frank26080115/SoccerRobot2019/circuit/pcbway_config.PNG

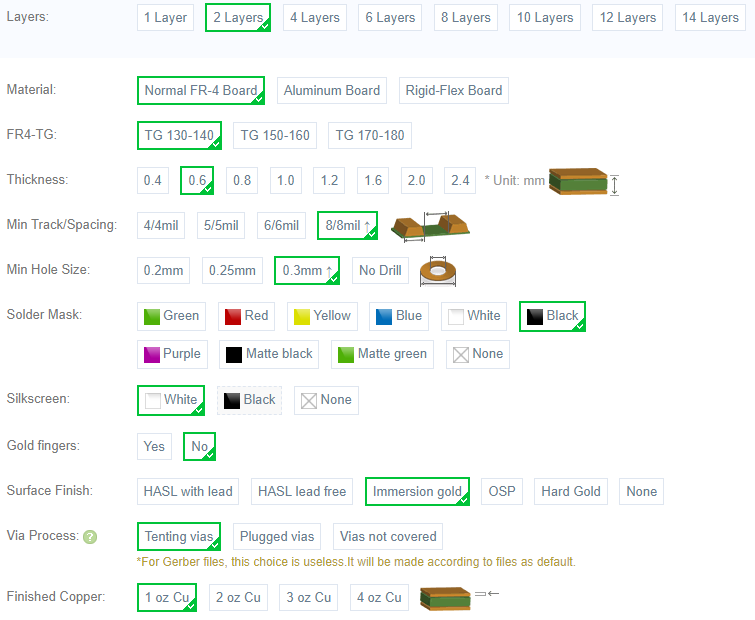
circuit/pcbway_config.PNG
