frank26080115/SoccerRobot2019/circuit/dirtcheaprxnano_billofmaterials.xlsx

Sheet: Bill of Materials
 |  |  | BOM: dirtcheaprx_nano
Item # | *Ref Des | *Qty | Mfg | *Mfg Part # | Description / Value | *Package | Type | Your Instructions / Notes
1 | U1 | 1 | Espressif | ESP-12E | ESP8266 Module | Module | SMD | ESP-12F and ESP-12S are acceptable
2 | IC1 | 1 | Microchip | MCP1703T-3302E/CB | Voltage Regulator +3.3V Output, 250mA | SOT-23-3 | SMD | No substitute
3 | C1 | 1 | *any* | *any* | CAP CER, 22 uF, 16V rated | 0805 | SMD | any temperature coeff, any tolerance
3 | C2 | 1 | *any* | *any* | CAP CER, 4.7 uF, 16V rated | 0805 | SMD | any temperature coeff, any tolerance
4 | C3 | 1 | *any* | *any* | CAP CER, 100 nF, 6V rated | 0603 | SMD | any temperature coeff, any tolerance, 100 nF to 1 uF acceptable
5 | R1, R4, R5 | 3 | *any* | *any* | RES 5.6 kohm, 10%, 1/10W | 0603 | SMD
6 | R2, R3 | 2 | *any* | *any* | RES 470 ohm, 10%, 1/10W | 0603 | SMD
Click for Instructions on How to Create a BOM (https://www.pcbway.com/blog/PCB_Assembly/How_to_Build_a_BOM__Bill_Of_Materials_.html)
PLEASE NOTE: COMPONENT COORDINATES ARE PROVIDED IN THIS FILE, IN ANOTHER SHEET

Sheet: Component Coordinates
Ref Des | X (mm) | Y (mm) | Rotation | Side | Footprint | Note
C1 | 11.50 | 9.90 | 90 | Top | 0805
C2 | 10.50 | 13.50 | 90 | Top | 0805
C3 | 16.90 | 12.55 | 0 | Top | 0603
IC1 | 8.00 | 11.95 | 0 | Top | SOT-23-3
R1 | 12.50 | 13.40 | 90 | Top | 0603
R2 | 14.50 | 13.40 | 90 | Top | 0603
R3 | 4.00 | 13.80 | 90 | Top | 0603
R4 | 17.30 | 9.80 | 90 | Top | 0603
R5 | 2.00 | 11.30 | 90 | Top | 0603
U1 | 9.8? | 10.6? | ??? | Bottom | Module | Unusual Part Package
