frank26080115/SoccerRobot2019/(threads)

Thread 2 (2018-10-09):

Robots can't move forward and turn at the same time

MiloMindbender, 2018-10-09:
The current implementation doesn't seem to be able to send rotate and forward/back commands at the same time.  This makes the robots harder to control.
