frank26080115/SoccerRobot2019/circuit/robot.brd

## EAGLE design circuit/robot.brd (2018-08-24)

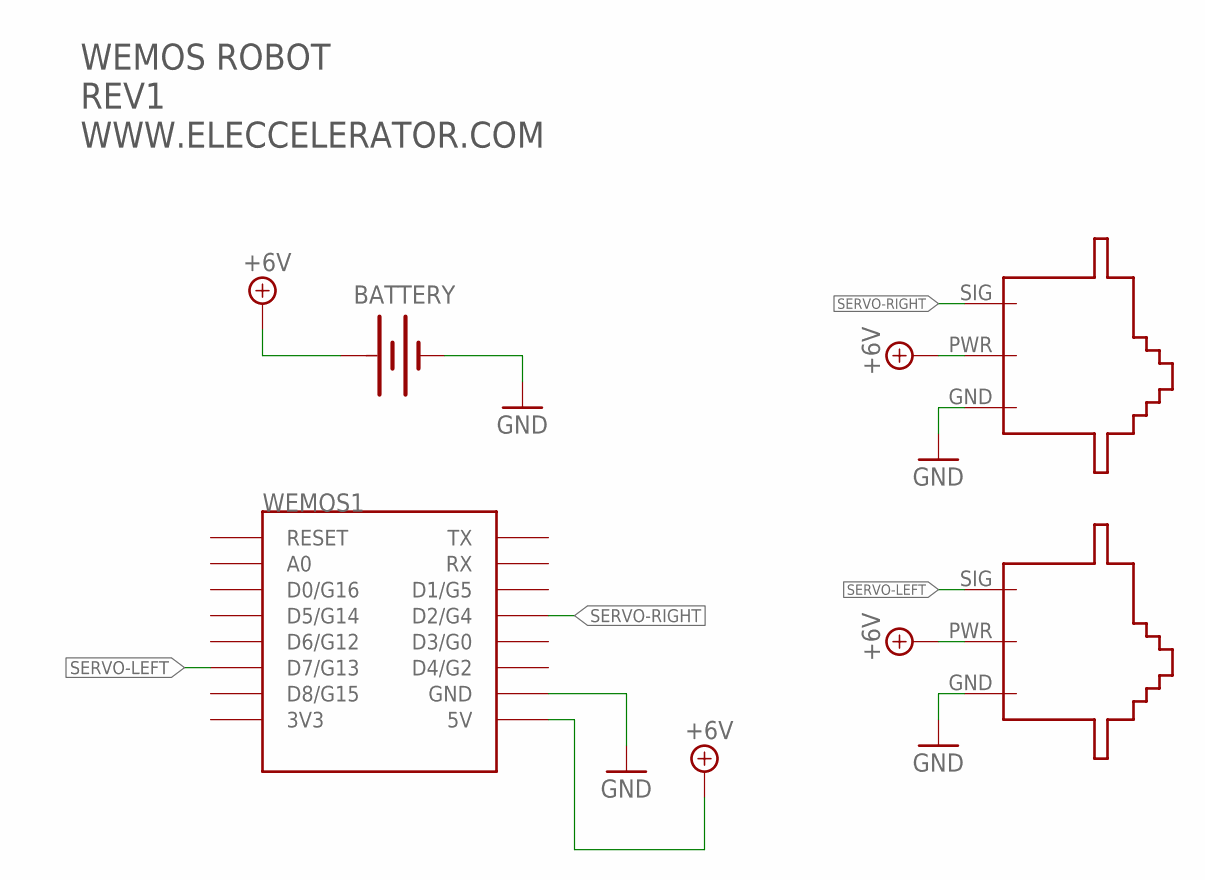
[picture p2: schematic robot.sch]

Parts:
BATTERY: BATTERY-WIRE-CONN; BATT-WIRE-CONN
M1: SERVO-FLIPPED
M2: SERVO-1; SERVO
U$1: HACKADAY-14MM; HACKADAY-1
U$9: TEXT-INFO-MINI
WEMOS1: WEMOS-D1-MINI

Connections:
+6V: BATTERY.POS (+), M1.PWR, M2.PWR, WEMOS1.5V
GND: BATTERY.NEG (-), M1.GND, M2.GND, WEMOS1.GND
SERVO-LEFT: M1.SIG, WEMOS1.D7 (D7/G13)
SERVO-RIGHT: M2.SIG, WEMOS1.D2 (D2/G4)

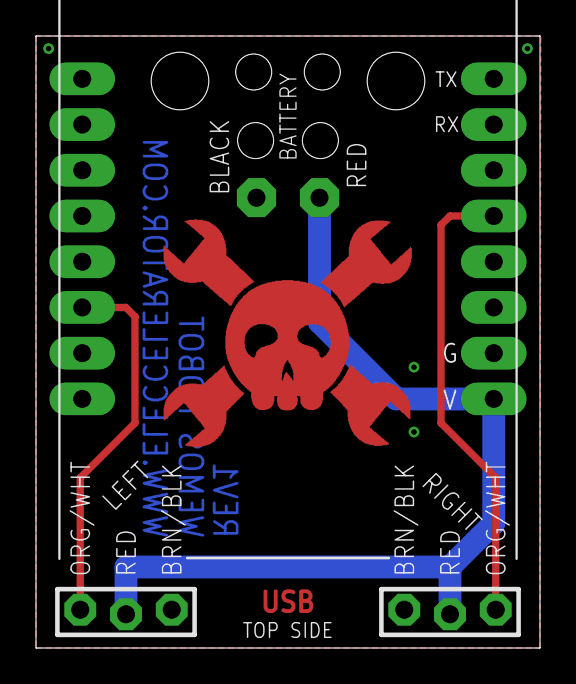
[picture p3: board robot.brd from above]

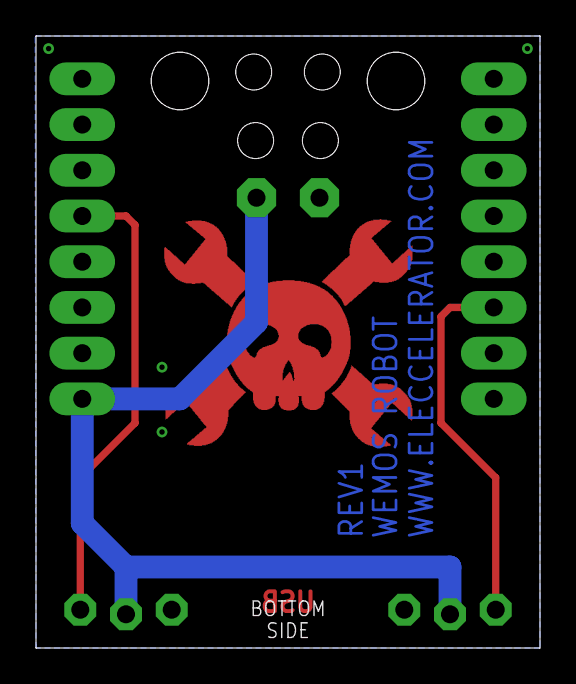
[picture p4: board robot.brd from below]

Board: 2 copper layers, 28.0 x 34.0 mm, 6 parts (2 on the bottom side), 4 nets.
