frank26080115/SoccerRobot2019/circuit/programmer.brd

## EAGLE design circuit/programmer.brd (2018-08-20)

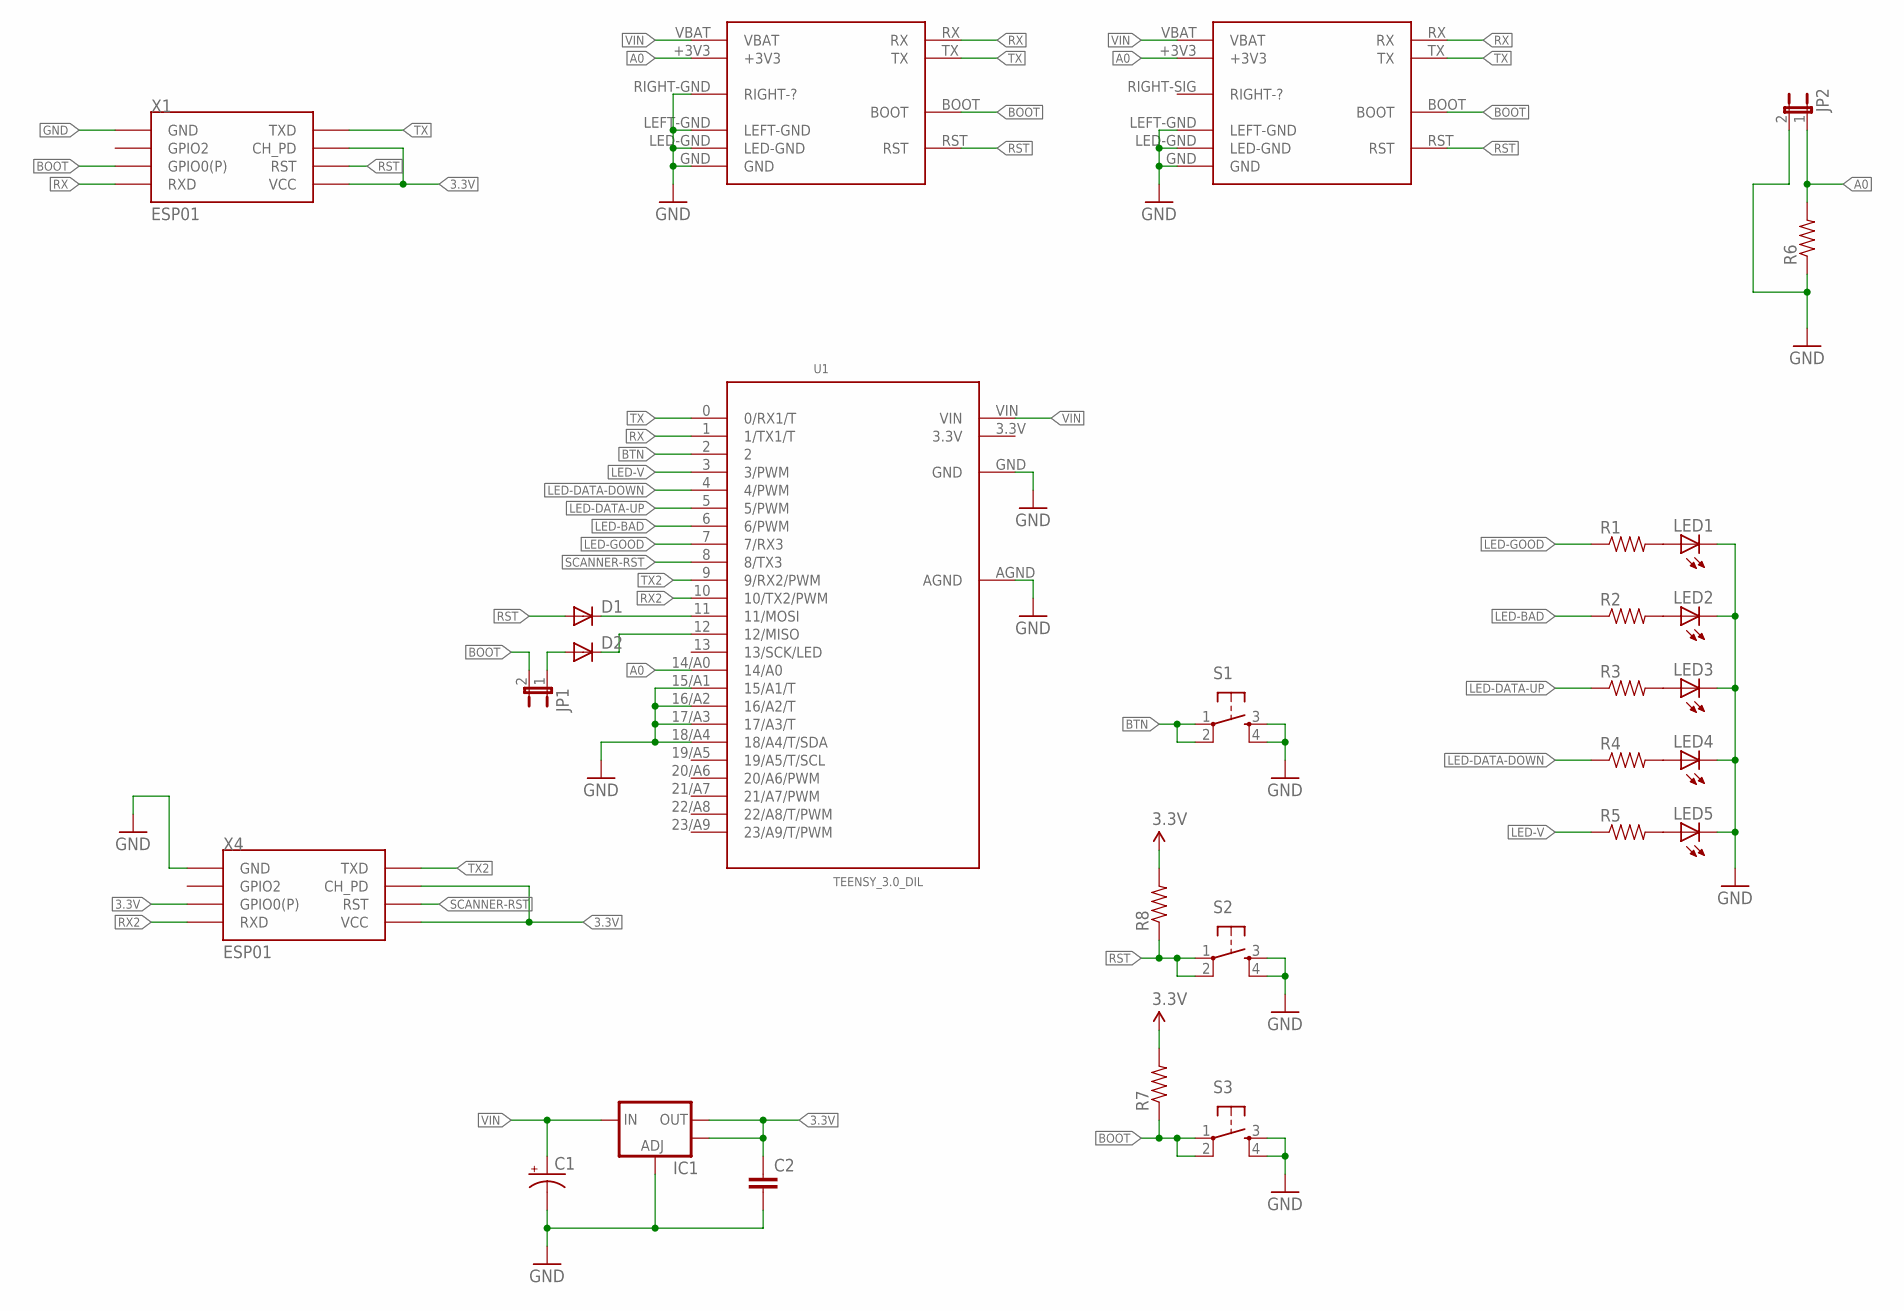
[picture p5: schematic programmer.sch]

Parts:
C1: CAP_POLPTH1; CPOL-RADIAL-100UF-25V
C2: CAPPTH2; CAP-PTH-SMALL2
D1, D2: DIODESOD; SOD-323
IC1: V_REG_LM1117SOT223; SOT223
JP1, JP2: JUMPER-2PTH_LOCK; 1X02_LOCK
LED1, LED2, LED3, LED4, LED5: LED5MM
R1, R2, R3, R4, R5, R6, R7, R8: RESISTOR0603-RES; 0603-RES
S1, S2, S3: TAC_SWITCHPTH; TACTILE-PTH
U1: TEENSY_3.0_DIL; TEENSY_3.0-3.2&LC_DIL
X1, X4: ESP01
X2: DIRTCHEAPRX-PROG-MINI; DIRTCHEAPRX_MINI_PROGPINS
X3: DIRTCHEAPRX-PROG-NANO; DIRTCHEAPRX_NANO_PROGPINS

Connections:
3.3V: C2.1, IC1.2 (OUT), IC1.4 (OUT), R7.2, R8.2, U1.3.3V, X1.CH_PD, X1.VCC, X4.CH_PD, X4.GPIO0 (GPIO0(P)), X4.VCC
A0: JP2.1, R6.2, U1.14/A0, X2.+3V3, X3.+3V3
BOOT: JP1.2, R7.1, S3.1, S3.2, X1.GPIO0 (GPIO0(P)), X2.BOOT, X3.BOOT
BTN: S1.1, S1.2, U1.2
GND: C1.2 (-), C2.2, IC1.1 (ADJ), JP2.2, LED1.K (C), LED2.K (C), LED3.K (C), LED4.K (C), LED5.K (C), R6.1, S1.3, S1.4, S2.3, S2.4, S3.3, S3.4, U1.15/A1 (15/A1/T), U1.16/A2 (16/A2/T), U1.17/A3 (17/A3/T), U1.18/A4 (18/A4/T/SDA), U1.AGND, U1.GND, X1.GND, X2.GND, X2.LED-GND, X2.LEFT-GND, X2.RIGHT-GND (RIGHT-?), X3.GND, X3.LED-GND, X3.LEFT-GND, X4.GND
LED-BAD: R2.1, U1.6 (6/PWM)
LED-DATA-DOWN: R4.1, U1.4 (4/PWM)
LED-DATA-UP: R3.1, U1.5 (5/PWM)
LED-GOOD: R1.1, U1.7 (7/RX3)
LED-V: R5.1, U1.3 (3/PWM)
unnamed: D1.1 (C), U1.11 (11/MOSI)
unnamed: LED1.A, R1.2
unnamed: LED2.A, R2.2
unnamed: LED3.A, R3.2
unnamed: LED4.A, R4.2
unnamed: LED5.A, R5.2
unnamed: D2.1 (C), U1.12 (12/MISO)
unnamed: D2.2 (A), JP1.1
RST: D1.2 (A), R8.1, S2.1, S2.2, X1.RST, X2.RST, X3.RST
RX: U1.1 (1/TX1/T), X1.RX (RXD), X2.RX, X3.RX
RX2: U1.10 (10/TX2/PWM), X4.RX (RXD)
SCANNER-RST: U1.8 (8/TX3), X4.RST
TX: U1.0 (0/RX1/T), X1.TX (TXD), X2.TX, X3.TX
TX2: U1.9 (9/RX2/PWM), X4.TX (TXD)
VIN: C1.1 (+), IC1.3 (IN), U1.VIN, X2.VBAT, X3.VBAT

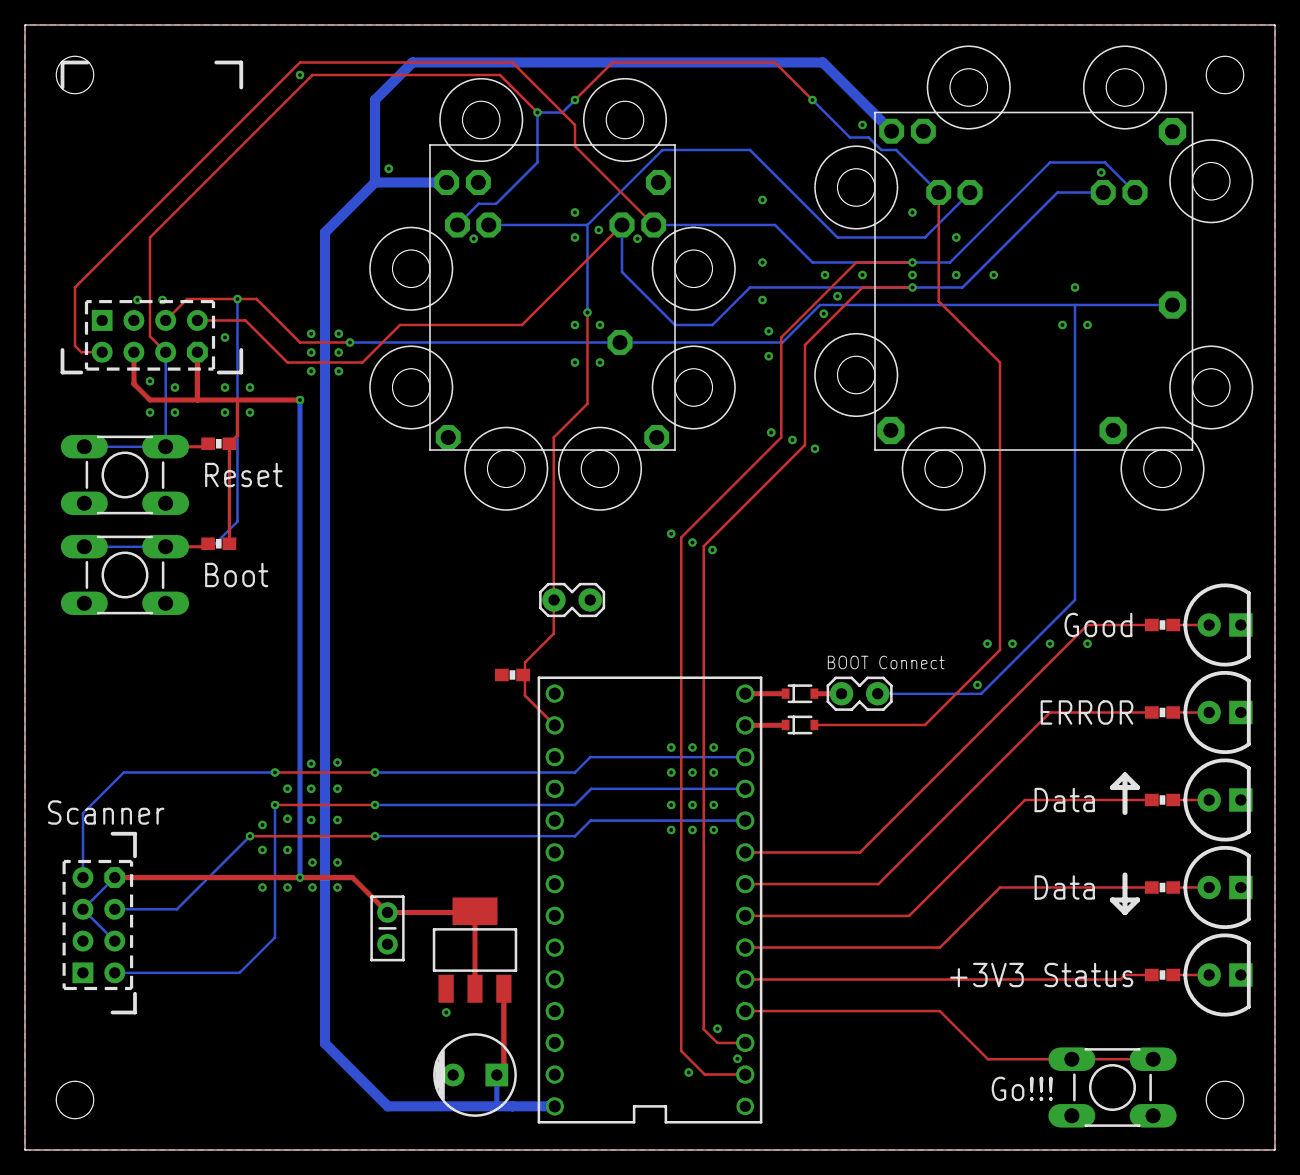
[picture p6: board programmer.brd from above]

Board: 2 copper layers, 100.0 x 90.0 mm, 28 parts (1 on the bottom side), 25 nets.
