frank26080115/SoccerRobot2019/circuit/dirtcheaprx_nano.brd

## EAGLE design circuit/dirtcheaprx_nano.brd (2018-08-20)

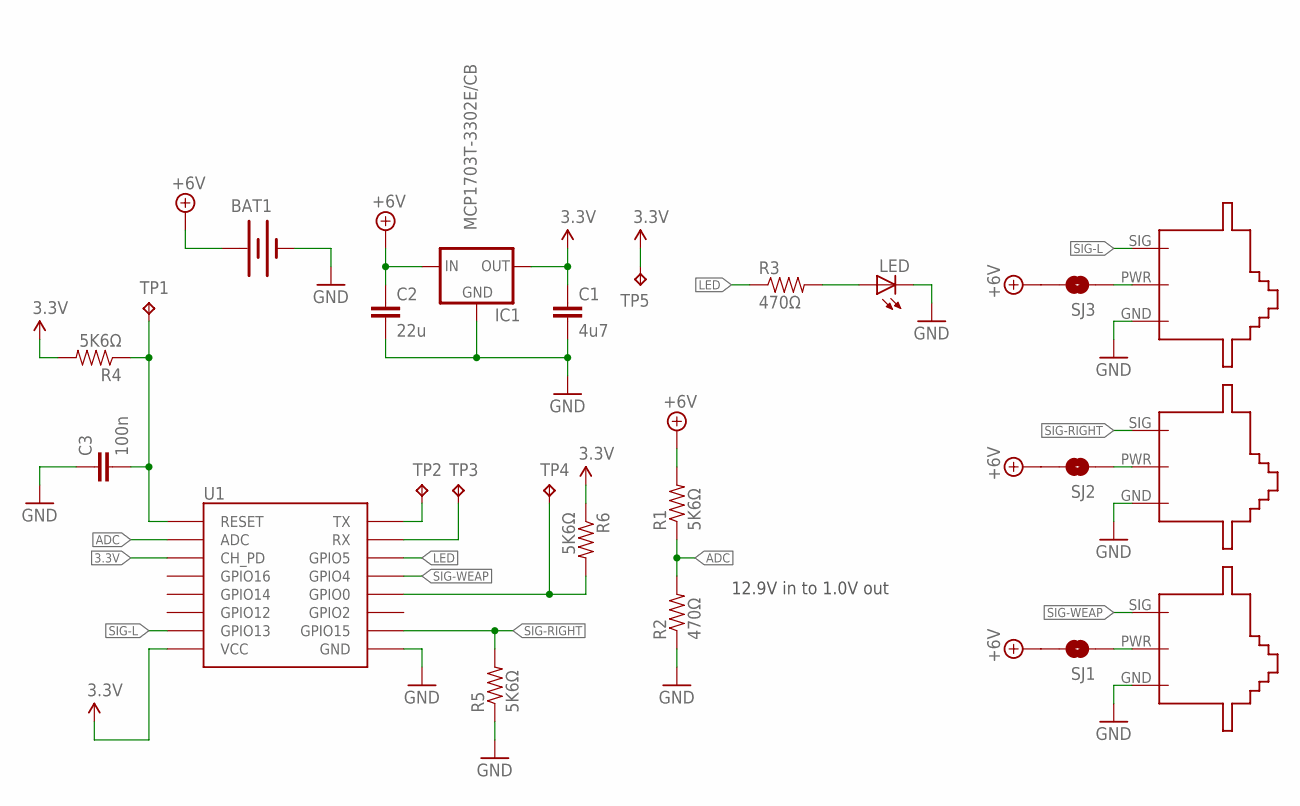
[picture p7: schematic dirtcheaprx_nano.sch]

Parts:
BAT1: BATTERY-WIRE-CONN; BATT-WIRE-CONN
C1: 4u7; 0805
C2: 22u; 0805
C3: 100n; 0603-CAP
IC1: MCP1703T-3302E/CB; SOT23-3
LED: LED5MM
R1, R4, R5, R6: 5K6Ω; 0603-RES
R2, R3: 470Ω; 0603-RES
SERVO1: SERVO-SMD-EDGE-1F; SERVO-EDGE-F
SERVO2, SERVO3: SERVO-SMD-EDGE-1; SERVO-EDGE
SJ1, SJ2, SJ3: SOLDERJUMPERNO; SJ_2S-NO
TP1, TP2, TP3, TP4, TP5: TPPAD1-13; P1-13
U1: ESP12SMD; ESP12SE-SMD

Connections:
3.3V: C1.1, IC1.2 (OUT), R4.2, R6.1, TP5.TP, U1.CH_PD, U1.VCC
+6V: BAT1.POS (+), C2.1, IC1.3 (IN), R1.2, SJ1.2, SJ2.2, SJ3.2
ADC: R1.1, R2.2, U1.ADC
GND: BAT1.NEG (-), C1.2, C2.2, C3.1, IC1.1 (GND), LED.K (C), R2.1, R5.1, SERVO1.GND, SERVO2.GND, SERVO3.GND, U1.GND
LED: R3.1, U1.GPIO5
unnamed: LED.A, R3.2
unnamed: SERVO1.PWR, SJ1.1
unnamed: SERVO2.PWR, SJ2.1
unnamed: SERVO3.PWR, SJ3.1
unnamed: C3.2, R4.1, TP1.TP, U1.RESET
unnamed: TP2.TP, U1.TXD0 (TX)
unnamed: TP3.TP, U1.RXD0 (RX)
unnamed: R6.2, TP4.TP, U1.GPIO0
SIG-L: SERVO3.SIG, U1.GPIO13
SIG-RIGHT: R5.2, SERVO2.SIG, U1.GPIO15
SIG-WEAP: SERVO1.SIG, U1.GPIO4

Notes on the sheet:
12.9V in to 1.0V out

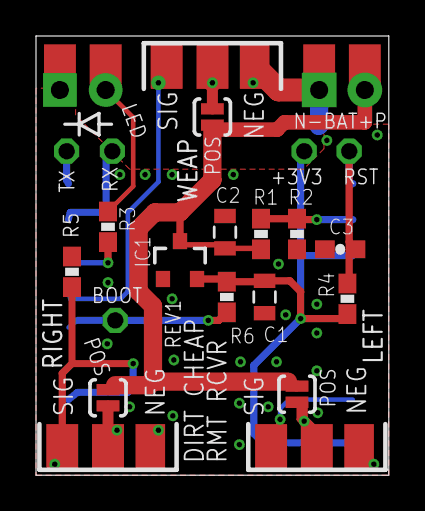
[picture p8: board dirtcheaprx_nano.brd from above]

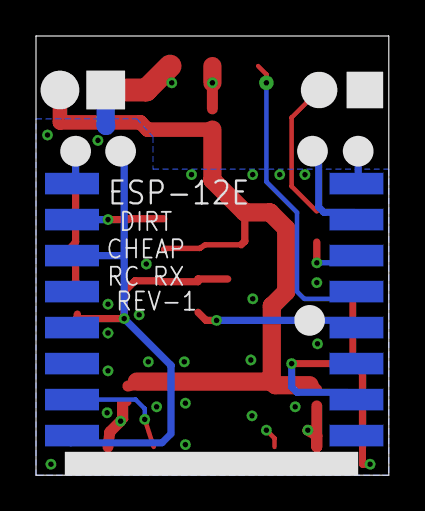
[picture p9: board dirtcheaprx_nano.brd from below]

Board: 2 copper layers, 19.6 x 24.4 mm, 24 parts (6 on the bottom side), 16 nets.
