frank26080115/SoccerRobot2019/ArduinoSketchbook/CaptivePortalAdvanced/CaptivePortalAdvanced.ino

#include <ESP8266WiFi.h>
#include <WiFiClient.h>
#include <ESP8266WebServer.h>
#include <DNSServer.h>
#include <ESP8266mDNS.h>
#include <EEPROM.h>

/*
   This example serves a "hello world" on a WLAN and a SoftAP at the same time.
   The SoftAP allow you to configure WLAN parameters at run time. They are not setup in the sketch but saved on EEPROM.

   Connect your computer or cell phone to wifi network ESP_ap with password 12345678.

   This is a captive portal because through the softAP it will redirect any http request to http://192.168.4.1/
*/

/* Set these to your desired softAP credentials. They are not configurable at runtime */
const char *softAP_ssid = "ESP_ap";
const char *softAP_password = "12345678";

/* hostname for mDNS. Should work at least on windows. Try http://esp8266.local */
const char *myHostname = "esp8266";

// DNS server
const byte DNS_PORT = 53;
DNSServer dnsServer;

// Web server
ESP8266WebServer server(80);

/* Soft AP network parameters */
IPAddress apIP(192, 168, 4, 1);
IPAddress netMsk(255, 255, 255, 0);

/** Current WLAN status */
unsigned int status = WL_IDLE_STATUS;

void setup() {
  delay(1000);
  Serial.begin(9600);
  Serial.println();
  Serial.print("Configuring access point...");
  /* You can remove the password parameter if you want the AP to be open. */
  WiFi.softAPConfig(apIP, apIP, netMsk);
  WiFi.softAP(softAP_ssid, softAP_password);
  delay(500); // Without delay I've seen the IP address blank
  Serial.print("AP IP address: ");
  Serial.println(WiFi.softAPIP());

  /* Setup the DNS server redirecting all the domains to the apIP */
  dnsServer.setErrorReplyCode(DNSReplyCode::NoError);
  dnsServer.start(DNS_PORT, "*", apIP);

  /* Setup web pages: root, wifi config pages, SO captive portal detectors and not found. */
  server.on("/", handleRoot);
  server.on("/wifi", handleWifi);
  server.on("/generate_204", handleRoot);  //Android captive portal. Maybe not needed. Might be handled by notFound handler.
  server.on("/fwlink", handleRoot);  //Microsoft captive portal. Maybe not needed. Might be handled by notFound handler.
  server.onNotFound(handleNotFound);
  server.begin(); // Web server start
  Serial.println("HTTP server started");
}

void loop() {
  {
    unsigned int s = WiFi.status();
    if (status != s) { // WLAN status change
      Serial.print("Status: ");
      Serial.println(s);
      status = s;
      if (s == WL_CONNECTED) {
        /* Just connected to WLAN */
        Serial.println("");
        Serial.print("Connected ");
        Serial.print("IP address: ");
        Serial.println(WiFi.localIP());

        // Setup MDNS responder
        if (!MDNS.begin(myHostname)) {
          Serial.println("Error setting up MDNS responder!");
        } else {
          Serial.println("mDNS responder started");
          // Add service to MDNS-SD
          MDNS.addService("http", "tcp", 80);
        }
      }
    }
  }
  // Do work:
  //DNS
  dnsServer.processNextRequest();
  //HTTP
  server.handleClient();
}
