frank26080115/SoccerRobot2019/(commit log)

2018-07-19 initial schematic and pcb
    [robot.brd, robot.sch]
2018-07-20 pcb rev cleanup
    [robot.brd]
2018-07-20 smaller pcb
    [robot.sch, robot_large.brd, robot_large.sch]
2018-07-21 actually applies servo flip
2018-07-21 update small PCB with version info
    [robot.brd, robot.sch]
2018-07-22 web stuff works, more settings, PCB configurable
    [robot_mini_r1.brd, robot_mini_r1.sch]
2018-07-23 working servo implementation, tested
2018-07-23 all 3 servos happy, UI tested
2018-07-29 PCBs, first proto batch
    [dirtcheaprx.brd, dirtcheaprx.sch, robot.brd, robot_large.brd, robot_large.sch, robot_mini_r1.brd]
2018-07-30 added hardware config header file for new PCB
2018-08-01 nano PCB for dirt cheap rx
    [dirtcheaprx_nano.brd, dirtcheaprx_nano.sch]
2018-08-02 json reply for battery status, untested
2018-08-02 various methods to factory reset
    [BasicRobot.ino, handleHttp.ino, tools.ino]
2018-08-02 minor changes to factory reset conditions
    [BasicRobot.ino]
2018-08-02 moved right servo sig trace above danger zone
    [dirtcheaprx_nano.brd]
2018-08-05 silk over testpoints on pcb
    [dirtcheaprx.brd, dirtcheaprx.sch]
2018-08-09 trying to fix the NVM read crash
    [handleHttp.ino]
2018-08-09 updated ArduinoJson library to latest
2018-08-10 GPIO15 needs to be pulled down, I missed the memo...
    [dirtcheaprx.brd, dirtcheaprx.sch, dirtcheaprx_nano.brd, dirtcheaprx_nano.sch]
2018-08-10 ArduinoJson update broke, put back the github version
    [BasicRobot.ino, handleHttp.ino]
2018-08-10 changed NVM struct to a pointer, did not fix loss of AP problem
    [BasicRobot.ino, handleHttp.ino]
2018-08-10 battery reading is taking too long? disabling for now, also password is static
    [BasicRobot.ino, handleHttp.ino]
2018-08-11 programmer pcb start
    [programmer.brd, programmer.sch]
2018-08-12 progress on programmer pcb
    [programmer.brd, programmer.sch]
2018-08-12 fixed analog reading being wrong
    [BasicRobot.ino, handleHttp.ino]
2018-08-12 work on programmer pcb
    [programmer.brd, programmer.sch]
2018-08-12 attempted to add multitouch for buttons, doesn't work
2018-08-12 servo flip drop down bug fix
    [handleHttp.ino]
2018-08-12 startup SPIFFS check fix
    [BasicRobot.ino]
2018-08-12 better servo movement reporting
2018-08-13 corrected GPIO4 and GPIO5 mixup in PCBs
    [dirtcheaprx.brd, dirtcheaprx.sch, dirtcheaprx_nano.brd, dirtcheaprx_nano.sch]
2018-08-15 multitouch buttons working for desktop chrome
2018-08-15 implemented standby button
2018-08-16 better battery reading
    [dirtcheaprx_nano.brd, dirtcheaprx_nano.sch, dirtcheaprxnano_billofmaterials.xlsx]
2018-08-18 resistor on GPIO0, flipped weap servo connector
    [dirtcheaprx_nano.brd, dirtcheaprx_nano.sch]
2018-08-18 programmer, more vias, disconnectable boot signal
    [programmer.brd, programmer.sch]
2018-08-18 programmer, changed drill sizes (might need to revert)
2018-08-18 diagnostic for flash size, added eraseConfig to factory reset
    [BasicRobot.ino]
2018-08-20 gerbers ordered
    [dirtcheaprx_nano.brd]
2018-08-20 second edition of the diy robot board with LM1117 vreg
    [robot.brd, robot.sch]
2018-08-20 gerber out, added some optional pull-up resistors
    [programmer.brd, programmer.sch]
2018-08-22 fixed captive portal for android oreo
    [BasicRobot.ino, handleHttp.ino, tools.ino]
2018-08-24 added Wemos based PCB
    [robot.brd, robot.sch]
